doanthanhnam1/Gear-reduce/calculate parameter.pdf

Tên: Đoàn Thanh Nam

MSSV: 20146506
Đề số 3 – phương án 8

Bài làm
Câu 1: tính toán công suất và tốc độ quay của trục công tác
1. Tốc độ quay của trục công tác ta có thể áp dụng công thức:

n =

Q
60FtμρLmTan(β)

Trong đó: Ft =

πD

2

4

=

3.14∗0.6

2

4

= 0.283(m²
)

L = mKDTan(β) =

1
3

∗ 200 ∗ 0.6 ∗ Tan(3

o
) = 0.296(m)
Vậy tốc độ quay n của trục công tác là:

n =

Q
60FtμρLmTan(β)

=

14800

60 ∗ 0.283 ∗

1
3

∗ 1300 ∗ 2.096 ∗

1
3

∗ Tan(3

o)
= 55.01(vg/pℎ)
2. Công suất cần cung cấp cho thùng trộn là: (đổi 81o =1.414 rad)
- Công suất nâng vật liệu lên độ cao thích hợp P1 là:

w =

πn
30 =

3.14 ∗ 55.01
30 = 5.76(rad/s)

P1 =

GV ∗ R0 ∗ (1 − Cos(α)) ∗ w α

∗ 10⁻³

=

2400 ∗

0.6
3

∗ (1 − Cos(1.414)) ∗ 5.76
1.414

∗ 10⁻³

= 1.65(kw)

- Công suất trộn vật liệu P2 là:

P2 =

GV ∗ R0 ∗ w ∗ Sin(α)
1000 | =

2400 ∗

0.6
3

∗ 5.76 ∗ Sin(1.414)
1000
= 2.73(kw)
- Công suất mất mát do ma sát ở ổ trục và thùng trộn là: P3 = 0.1(P1 + P2

) = 0.1(1.65 + 2.73) =0.44(kw)

Vậy công suất cần cung cấp cho trục công tác là:

P = P1 + P2 + P3 = 1.65 + 2.73 + 0.44 = 4.82(kw)

Vận tốc quay n của trục công tác là:

n = 55.01(vg/ph)

Câu 2: Chọn động cơ và phân phối tỉ số truyền:

1. Chọn động cơ
Công suất trên trục công tác là: P = 4.82(kw) Hiệu suất của hệ thống là:

η = η01η12η23 = ηknηbrηxηol

3
Bánh trụ răng côn được che kín nên chọn ηbr = 0.96
Bộ truyền xích để hở nên chọn ηx = 0.93
Cặp ổ lăn chọn ηol = 0.995
Vậy hiệu suất hệ thống η = 1 ∗ 0.96 ∗ 0.93 ∗ 0.995³ = 0.88 ➔ Công suất cần thiết trên trục động cơ là: Pdc =

P
η

=

4.82
0.88

= 5.48(kw)
Ta có tốc độ quay trên trục công tác là n = 55.01(vg/ph)
- Chọn sơ bộ tỉ số truyền:
Tỉ số truyền nên dùng của hộp giảm tốc một cấp là 2..4 Tỉ số truyền nên dùng cho truyền động xích là 2..5
Vậy tỉ số truyền của cả hệ là 2*2..4*5 là 4..20
Vậy chọn usb = 13
Số vòng quay sơ bộ: nsb = usb*n = 13*55.01 = 715.13(vg/ph)

Số vòng quay đồng bộ: ndb = 750(vg/ph)

Chọn động cơ thỏa điều kiện:

u = 380V
Pct < Pdc
ndb = 750

➔ Kết quả:
Động cơ | 160M8B
Công suất (kw) | 5.5
Số vòng quay (vg/ph) | 715
Khối lượng (kg) | 125
Moment quán tính (kgm² ) | 0.09524
2. Phân phối tỉ số truyền:
- Tính tỉ số truyền thực ut =

ndc

nct

=

715
55.01

= 13
- Chọn tỉ số truyền của hộp giảm tốc: ubr = 4.0
- Tỉ số truyền ngoài hộp giảm tốc: ux =

ut

ubr

=

13
4

= 3.3

- Kiểm tra sai lệch: ∆u =

|ut−u|
ut

=

|13−4∗3.3|
13

=

|13−13.2|
13

= 1.54% ≤ 4%
- Tính số vòng quay trên các trục: Trục 01: n1 = ndc = 715(vg/ph) Trục 02: n2 =

n1

ubr

=

715
4

= 178.75(vg/pℎ)

Trục công tác: nct =

n2
ux

=

178.75
3.3

= 54.17 (vg/pℎ)

- Tính công suất trên các trục: Trục 02: P2 =

Pct
η23

=

Pct

ηxηol

=

4.82
0.93∗0.995

= 5.21(kw)

Trục 01: P1 =

P2
η12

=

P2

ηbrηol

=

5.21
0.96∗0.995

= 5.45(kw)

Trục động cơ: Pdc =

P1
η01

=

P1

ηntηol

=

5.45
1∗0.995

= 5.48(kw)

- Tính moment trên các trục:

Tdc =

9.55 ∗ 10⁶
∗ 5.48
715 | = 73194(Nmm)

Trục 01:

T1 =

9.55 ∗ 10⁶
∗ 5.45
715 | = 72794(Nmm)

Trục 02:

T2 =

9.55 ∗ 10⁶
∗ 5.21
178.75 = 278352(Nmm)

Trục công tác:

Tct =

9.55 ∗ 10⁶
∗ 4.82
54.17 = 849751(Nmm)

Bảng đặc tính kỹ thuật:

Trục Thông số | Động cơ | I | II | Công tác
Công suất (kw) | 5.48 | 5.45 | 5.21 | 4.82
Tỉ số truyền | unt = 1 ubr = 4 ux = 3.3
Tốc độ quay (v/ph) | 715 | 715 | 178.75 | 54.17
Momen xoắn (Nmm) | 73194 | 72794 | 278352 | 849751

Câu 3: tính toán bộ truyền ngoài hộp giảm tốc: bộ truyền xích

- Dựa vào bảng ở câu 2, ta có:
Công suất trên trục của đĩa xích dẫn P1 = P2 = 5.21(kw)
Tốc độ quay trên trục chứa đĩa xích dẫn n1 = n2 = 178.75(vg/ph) Tỷ số truyền của bộ truyền xích ux = 3.3
- Chọn lọai xích → Chọn ống xích con lăn vì vận tốc thấp
- Chọn số răng đĩa xích Z1 và Z2:
Z1 = 29 − 2 ∗ 3.3 = 22.4 ≥ 19 → Chọn Z1 = 23
Z2 = u ∗ Z1 = 3.3 ∗ 23 = 75.9 ≤ Zmax = 120 → Chọn Z2 = 77 Tính tỉ số truyền thực tế: ut =

Z2
Z1

=

77
23

= 3.35

Kiểm tra sai lệch tỉ số truyền: ∆u =

|ut−u|
ut

=

|3.35−3.3|
3.35

= 1.49% ≤ 4%

- Xác định bước xích p
kn =

n01
n1

=

200
178.75

= 1.12

kZ =

Z01
Z1

=

25
23

= 1.09
k = kđ ∗ ka ∗ k0 ∗ kdc ∗ kbt ∗ kc = 1 ∗ 1 ∗ 1 ∗ 1 ∗ 1.3 ∗ 1.25 = 1.62

Xích 1 dãy (kd = 1) có công suất tính toán: Pt =

P1∗k∗kZ∗kn
kd

=

5.21∗1.62∗1.09∗1.12
1

=10.3(kw)
Tra bảng công suất cho phép của xích con lăn khi n01 = 200 Pt ≤ [Po

] = 11(kw)
➔ Chọn bước xích: p = 25.4 ≤ pmax

∆P =

11 − 10.3
10.3

∗ 100% = 6.8%

Tuy ∆P < 10% nhưng với p = 25.4mm thì đường kính đĩa xích bị dẫn lớn

d2 =

25.4

sin (

180
77 )

= 622(mm)

Trong điều kiện này ta nên chọn p có trị số nhỏ hơn và tăng số đĩa xích, bằng cách thay đổi số dãy xích theo công thức:

Pt =

P1 ∗ k ∗ kZ ∗ kn
kd

< [P] → kd >

10.3
4.8

= 2.15

Vì kd > 2.15 → kd = 2.5 tương đương là 3 dãy xích có bước xích p = 19.05 mm

- Xác định khoảng cách trục a và số mắt xích X
Chọn asb = 40p = 40*19.05= 762 mm
Tính số mắt xích X:

X =

2a
p

+

(Z1 + Z2

)
2

+

p
a

(

Z2 − Z1
2π

)

2

=

2 ∗ 762
19.05 +

(23 + 77)
2

+

19.05
762 (

77 − 23
2 ∗ 3.14)

2
= 131.85
Lấy số mắt xích chẵn: X=132 (mắt xích) Tính lại khoảng cách trục a:

a

′ =

1
4

p [X −
(Z1 + Z2

)
2

+ √(X −
Z1 + Z2
2

)

2
− 2 (

Z2 − Z1
π

)

2

]

=

1
4

19.05 [132 −
(23 + 77)
2

+ √(132 −
(23 + 77)
2

)

2 − 2(

(77 − 23)
3.14 )

2]

= 763.5(mm)
Để xích không quá căng thì giảm a một lượng:

a = a

′ − ∆a =763.5-0.003*763.5=761.21≈ 762 số lần va đập trong 1 giây: i =

Z1n1
15X

=

23∗178.75
15∗132

= 2.08 ≈ 2 ≤ [i] = 35

- Kiểm nghiệm xích về độ bền S =

Q
kđFt+F0+Fv

≥ [S]

kf = 4 do xích nghiêng góc 30o Q = 108*10³
(tra bảng xích 3 dãy)
1m xích nặng q = 5.8kg
F0 = 9.81kf*q*a = 9.81*4*5.8*0.761 =172.2(N)

v =

Z1n1p
60000 =

23 ∗ 178.75 ∗ 19.05
60000 | = 1.31(m/s)
Fv = qv

2 = 5.8 ∗ 1.31² = 9.95(N)

Ft =

1000P2
v

=

1000 ∗ 5.21
1.31 = 3977.1(N)

Vậy S =

Q
kđFt+F0+Fv

=

108000
1∗3977.1+172.2+9.95
| = 25.97

Theo Bảng 5.10 với p = 19,05; n2 = 178.75 v/ph Þ [S] = 8,2 Vậy S = 25.97 > [S] = 8,2: bộ truyền xích đảm bảo độ bền
- Các thông số của đĩa xích

Đường kính vòng chia đĩa xích:

d1 = p/sin(180/z1) = 19.05/sin(180/23)=140mm
d2 = p/sin(180/z2) = 19.05/sin(180/77)=467.04mm lấy d2 = 467mm

Đường kính vòng đỉnh răng:

da1 = p[0,5 + cotg(π/z1 )] = 19.05[0.5+cotg(π/23)] = 148mm

da2 = p[0,5 + cotg(π/z2 )] = 19.05[0.5+cotg(π/77)] = 476mm

Đường kính vòng chân răng:

df1 = d1 - 2r = 140 – 2*(0.5025*11.91+0.05) = 128mm

df2 = d2 - 2r = 467 – 2*(0.5025*11.91+0.05) = 455mm

- Kiểm nghiệm độ bền tiếp xúc của đĩa xích:
σH = 0,47√kr(Ftkđ + Fvđ)
| E
| Akd

Trong đó:

kr = 0.48 + (23 − 20) ∗

0.36 − 0.48
30 − 20 = 0.444

A = 265mm²

kđ = 1

kd = 2.5

Fvđ = 13*10⁻⁷*n1*p³m= 13*10⁻⁷*178.75*19.05³*1=1.61 (N)

Vậy:
σH = 0.47√0.444(3977.1 + 1.61) 2.1 ∗ 10⁵
265 ∗ 2.5

= 351.7(MPa)

Vì vật liệu là sắt 45 có [σH] = 500 (MPa) > σH = 351.7 nên thõa điều kiện

- Lực tác dụng lên trục:
Fr = kx ∗ Ft = 1.15 ∗ 3977.1 = 4573.67

Các thông số bộ truyền xích:

Thông số | Kí hiệu | Trị số
Khoảng cách trục | a (mm) | 762
Số răng đĩa xích dẫn | Z1 | 23
Số răng đĩa xích bị dẫn | Z2 | 77
Tỉ số truyền | u | 3.35
Số mắt xích | X | 132
Đường kính vòng chia đĩa xích dẫn | d1 | 140
Đường kính vòng chia đĩa xích bị dẫn | d2 | 467
Đường kính vòng đỉnh đĩa xích dẫn | da1 | 148
Đường kính vòng đỉnh đĩa xích bị dẫn | da2 | 476
Đường kính vòng chân răng đĩa xích dẫn | df1 | 128
Đường kính vòng chân răng đĩa xích bị dẫn | df2 | 455
Bước xích | P (mm) | 19.05
Số dãy xích | | 3

Câu 3 (part 2): tính toán bộ truyền trong hộp giảm tốc: bánh răng côn

Dựa vào bảng đặc tính kĩ thuật ở câu 2, ta có:
Công suất trên trục bánh răng dẫn: P1 = 5.45 (kW)

Tốc độ quay trên trục bánh răng dẫn n1 = 715 (vg/ph)

Tỉ số truyền u = ubr = 4

Mô men xoắn trên trục bánh răng dẫn T1 = 72794 (Nmm)

Thời gian làm việc 5 năm (300 ngày/năm, 2 ca/ngày, 6 giờ/ca) (đề cho)

- Chọn vật liệu:
Bánh răng dẫn: thép 45 tôi cải thiện, đạt độ rắn HB 241 ÷ 285 có giới hạn bền σb1 = 850 MPa, giới hạn bền chảy σch1 = 580 MPa, chọn độ rắn bánh răng dẫn HB1 = 250 MPa

Bánh răng bị dẫn: thép 45 tôi cải thiện, đạt độ rắn HB 192 ÷ 240 có giới hạn bền σb2 = 750 MPa, giới hạn bền chảy σch2 = 450 MPa, chọn độ rắn bánh răng bị dẫn HB2 = 235 MPa.

- ứng suất cho phép:

với thép 45, tôi cải thiện đạt độ rắn HB 180 ÷ 350:

σHlim

o | = 2HB + 70; SH = 1.1; σFlim
o | = 1.8HB; SF = 1.75

σHlim1

o | = 2HB1 + 70 = 570 MPa; σFlim1
o | = 1.8HB1 = 450 MPa

σHlim2

o | = 2HB2 + 70 = 540 MPa; σFlim2
o | = 1.8HB2 = 423 MPa

NHo = 30HHB

2.4

→ NHo1 = 30 ∗ 250².4 = 1.7 ∗ 10⁷

; NHo2 = 30 ∗ 235².4 = 1.47 ∗ 10⁷

Khi bộ truyền làm việc với tải trọng tĩnh:

NHE = NFE = 60cnt∑

t∑ = 5 ∗ 300 ∗ 2 ∗ 6 = 18000 giờ
NHE1 = NFE1 = 60cnt∑ = 60 ∗ 1 ∗ 715 ∗ 18000 = 77.22 ∗ 10⁷

NHE2 = NFE2 = 60c

n1
u1

t∑ = 60 ∗ 1 ∗

715
4

∗ 18000 = 19.31 ∗ 10⁷

NHE2 > NHo2 do đó KHL2 = 1

Tương tự NHE1 > NHo1 do đó KHL1 = 1

Như vậy, sơ bộ xác định được

[σH] = σHlim1

o KHL/SH

[σH1

] = 570 ∗

1
1.1

= 518.18 MPa

[σH1

] = 540 ∗

1
1.1

= 490.9 MPa

Bộ truyền bánh răng nón răng thẳng nên chọn [σH] có trị số nhỏ hơn của [σH1] và [σH2]: [σH] = [σH2] 490,9 MPa
Vì NFE2 > NFo do đó KFL2 = 1

Tương tự NFE1 > NFo1 do đó KFL1 = 1

Bộ truyền quay 1 chiều KFC = 1

[σF

] = σFlim

o KFCKFL/SF

[σF1

] = 450 ∗ 1 ∗

1
1.75 = 257.14 MPa

[σF2

] = 423 ∗ 1 ∗

1
1.75 = 241.71 MPa

ứng suất quá tải cho phép được xác định:

với tôi cải tℎiện: [σH]max = 2.8σcℎ2 = 2.8 ∗ 450 = 1260 MPa

với HB < 350: [σF1

]max = 0.8σcℎ1 = 0.8 ∗ 580 = 464 MPa

[σF2

]max = 0.8σcℎ2 = 0.8 ∗ 450 = 360 MPa

- Chiều dài côn ngoài được tính theo công thức:

Re = KR√u

2 + 1√
T1KHβ
(1 − Kbe)Kbeu[σH]

2

3

Trong đó KR = 0,5Kd = với Kd = 100 MPa¹/3 = khi bộ truyền bánh răng côn bằng thép. Chọn Kbe = 0,25

(Kbe chỉ thay đổi trong phạm vi hẹp Kbe = 0,25÷0,3 với u > 3 → chọn 0.25)

Kbeu
2 − Kbe

=

0.25 ∗ 4
2 − 0.25 = 0.57

Tra bảng kết hợp HB < 350, ta chọn KHβ = 1.13 (trục bánh răng côn lắp trên ổ đũa, sơ đồ I, HB < 350)

mômen xoắn trên trục bánh răng dẫn T1 = 72794

Tính được:

Re = 50√4

2 + 1√
72794 ∗ 1.13
(1 − 0.25) ∗ 0.25 ∗ 4 ∗ 490.9

2

3
= 158.58 mm
- Xác định các thông số ăn khớp: Số răng bánh dẫn:

de1 =

2Re
√1 + u
2

=

2 ∗ 158.58
√1 + 4
2

= 76.92 mm

Với de1 = 76.92mm và u = 4, tra bảng ta được Z1p = 17

Với HB < 350, Z1 = 1.6 *Z1p = 1.6*17=27.2≈ 28

Đường kính trung bình với module trung bình:
dm1 = (1 − 0.5Kbe)de1 = (1 − 0.5 ∗ 0.25) ∗ 76.92 = 67.3 mm

mtm =

dm1
Z1

=

67.3
28 = 2.4 mm

mte =

mtm
1 − 0.5Kbe

=

2.4
1 − 0.5 ∗ 0.25 = 2.74 mm

Chọn mte = 3

Tính lại:
mtm = mte(1 − 0.5Kbe) = 3 ∗ (1 − 0.5 ∗ 0.25) = 2.63 mm

dm1 = mtm ∗ Z1 = 2.63 ∗ 28 = 73.64 mm

Số răng bánh bị dẫn:

Z2 = uZ1 = 4 ∗ 28 = 112, chọn Z2 = 112

Do đó tỉ số truyền um =

112
28

= 4

Sai số tỉ số truyền ∆u =

u−um
u

∗ 100 =

4−4
4

∗ 100 = 0% < 2%

Góc côn chia:
δ1 = arctg (

Z1
Z2

) = arctg (

28
112) = 14°2
′11′′

δ2 = 90° − δ1 = 90° − 14°16′52′′ = 75°57′49′′

Chiều dài côn ngoài đời thực:

Re = 0.5 ∗ mte√Z2
2 + Z1

2 = 0.5 ∗ 3√112² + 28² = 173.17 mm

- Kiểm nghiệm răng về độ bền tiếp xúc
Ứng suất tiếp xúc trên bề mặt răng được tính theo công thức: σH = ZmZHZε√
2T1KH√u
2 + 1
0.85bdm1

2 u
Zm = 274MPa¹/3
Bộ truyền bánh răng côn răng thẳng nên ZH = 1,76 Hệ số trùng khớp ngang εα được tính theo:

εα = [1.88 − 3.2 (

1
Z1

+

1
Z2

)] cos(βm) = 1.88 − 3.2 (

1
28 +

1
112) ∗ 1 = 1.74

Zε = √(4 − εα)/3 = √(4 − 1.74)/3 = 0.87

KH = KHβKHαKHv

Với bánh răng côn răng thẳng thì KHα = 1

Vận tốc: v =

πdm1n1
60000

=

π∗73.64∗715
60000

= 2.76 (m/s)

Chọn cấp chính xác theo vận tốc vòng, cấp chính xác: cấp 8

Công thức: vH = δHg0v√dm1(u + 1)/u

δH là hệ số kể đến ảnh hưởng của các sai số ăn khớp, δH = 0.006

g0 là hệ số kể đến ảnh hưởng của sai lệch các bước răng bánh 1 và 2

g0 = 56 (cấp cℎínℎ xác 8)

Thay các trị số trên, ta được:

vH = 0.006 ∗ 56 ∗ 2.76√73.64 ∗
4+1
4

= 8.9

Chiều rộng vành răng b = KbeRe = 0.25 ∗ 173.17 = 43.29, lấy b = 44mm

Thay các trị số trên để tính KHv

KHv = 1 +

vHbdm1

2T1KHβKHα

= 1 +

8.9∗44∗73.64
2∗72794∗1.13∗1

= 1.18

Dó đó: KH = KHβKHαKHv = 1.13 ∗ 1 ∗ 1.18 = 1.33

Ứng suất tiếp xúc:

σH = ZmZHZε√
2T1KH√u²+1
0.85bdm1

2 u

= 274 ∗ 1.76 ∗ 0.87√
2∗72794∗1.33∗√4
2+1
0.85∗44∗73.64²∗4
= 416.2 MPa

➔ σH < [σH] = 490.9 MPa Thõa mãn độ bền tiếp xúc
- Kiểm nghiệm răng về độ bền uốn:

Để đảm bảo độ bền uốn cho răng, ứng suất uốn sinh ra tại chân răng được tính theo công thức:

σF1 = 2T1 ∗ KF ∗ Yε ∗ Yβ ∗ YF1

/(0.85bdm1mnm) < [σF1

]

Với trị số

Kbeu
2−Kbe

=

0.25∗4
2−0.25

= 0.57, chọn KFβ = 1.25

KFα = 1 do bánℎ răng côn răng tℎẳng

hệ số kể đến tải trọng động xuất hiện trong vùng ăn khớp, tính theo công thức: KFv = 1 + vFbdm1/(2T1KFβKFα)

với vF = δFg0v√dm1(u + 1)/u

δF = 0.016

g0 = 56 (cấp chính xác 8)

vF = 0.016 ∗ 56 ∗ 2.76√
73.64 ∗ (4 + 1)
4

= 23.73

KFv = 1 +

23.73 ∗ 44 ∗ 73.64
2 ∗ 72794 ∗ 1.25 ∗ 1

= 1.42

Do đó: KF = KFβ ∗ KFα ∗ KFv = 1.25 ∗ 1 ∗ 1.42 = 1.78

với răng thẳng Yβ = 1

Yε =

1
εα

=

1
1.74 = 0.57

Số răng của bánh răng tương đương:

Zvn1 =

Z1
cos(δ1

)

=

28
cos (14°2

′11′′)

= 28.86

Zvn2 =

Z2
cos(δ2

)

=

112
cos (75°57′49′′)

= 462.96

Chọn bánh răng không dịch chỉnh, tra bảng, ta được

YF1 = 3.8; YF2 = 3.6

σF1 =

2 ∗ 72794 ∗ 1.78 ∗ 0.57 ∗ 1 ∗ 3.8
0.85 ∗ 44 ∗ 73.64 ∗ 2.63 = 77.49MPa < [σF1

] = 257.14MPa

σF2 = σF1

∗

YF2

YF1

= 77.49 ∗

3.6
3.8

= 73.41 MPa < [σF2

] = 241.71 MPa

Thỏa độ bền uốn

- Kiểm nghiệm răng về quá tải: Hệ số quá tải Kqt =

Tmax
T

= 1
Để tránh biến dạng dư hoặc gãy giòn bề mặt, ứng suất tiếp xúc cực đại phải thỏa điều kiện:

σHmax = σH√Kqt = 427.91√1 = 427.91 MPa < [σH]max = 1260 MPa

Kiểm nghiệm quá tải về độ bền uốn theo công thức:

σF1max = σF1√Kqt = 77.49√1 = 77.49MPa < [σF1
]max = 464 MPa σF2max = σF2√Kqt = 73.41√1 = 73.41 MPa < [σF2
]max = 360 MPa
- Bảng thiết kế bộ truyền bánh răng côn răng thẳng
Thông số | Ký hiệu | Giá trị | Đơn vị
Chiều dài côn ngoài | Re | 173.17 | mm
Mô đun vòng ngoài | mte | 3 | mm
Tỉ số truyền | ut | 4
Chiều rộng vành răng | b | 44 | mm
Góc côn chia | δ1; δ2 | ′11′′ δ1 = 14°2 δ2 = 75°57′49′′ | Độ
Số răng bánh nhỏ | Z1 | 28 | Răng
Số răng bánh lớn | Z2 | 112 | Răng
Hệ số dịch chỉnh | x1; x2 | x1 = 0; x2 = 0
Góc nghiên của răng | β | 0 | Độ
Công suất trục bánh răng dẫn | P1 | 5.45 | Kw
Tốc độ quay của trục dẫn | n1 | 715 | Vg/ph
Mô men xoắn trên trục dẫn | T1 | 72794 | Nmm
Thời gian làm việc | t∑ | 18000 | Giờ
Đường kính vòng chia ngoài bánh nhỏ | de1 | mte* Z1=84 | mm
Đường kính vòng chia ngoài bánh lớn | de2 | mte* Z2=336 | mm
Đường kính đỉnh răng ngoài bánh nhỏ | da1 | mte(Z1+2*cos(δ1)) = 90 | mm
Đường kính đỉnh răng ngoài bánh lớn | da2 | mte(Z2+2*cos(δ2))=338 | mm

PHẦN IV. TÍNH TOÁN VÀ THIẾT KẾ TRỤC

Trục Động cơ | Động cơ | I | II | Làm việc
Công suất (kw) | 5.48 | 5.45 | 5.21 | 4.82
Tỉ số truyền | unt = 1 ubr = 4 ux = 3.3
Tốc độ quay (v/ph) | 715 | 715 | 178.75 | 54.17
Momen xoắn (Nmm) | 73194 | 72794 | 278352 | 849751
- Bảng thiết kế bộ truyền bánh răng côn răng thẳng:
Thông số | Ký hiệu | Giá trị | Đơn vị
Chiều dài côn ngoài | Re | 173.17 | mm
Mô đun vòng ngoài | mte | 3 | mm
Tỉ số truyền | ut | 4
Chiều rộng vành răng | b | 44 | mm
Góc côn chia | δ1; δ2 | δ1 = 14°2 ′11′′ δ2 = 75°57′49′′ | Độ
Số răng bánh nhỏ | Z1 | 28 | Răng
Số răng bánh lớn | Z2 | 112 | Răng
Hệ số dịch chỉnh | x1; x2 | x1 = 0; x2 = 0
Góc nghiên của răng | β | 0 | Độ
Công suất trục bánh răng dẫn | P1 | 5.45 | Kw
Tốc độ quay của trục dẫn | n1 | 715 | Vg/ph
Mô men xoắn trên trục dẫn | T1 | 72794 | Nmm
Thời gian làm việc | t∑ | 18000 | Giờ
Đường kính vòng chia ngoài bánh nhỏ | de1 | mte* Z1=84 | mm
Đường kính vòng chia ngoài bánh lớn | de2 | mte* Z2=336 | mm
Đường kính đỉnh răng ngoài bánh nhỏ | da1 | mte(Z1+2*cos(δ1)) = 90 | mm
Đường kính đỉnh răng ngoài bánh lớn | da2 | mte(Z2+2*cos(δ2))=338 | mm
Lực vòng | Ft | 2T1 = 1977.02 Ft1 = Ft2 = dm1 | N

Lực hướng tâm | Fr | Fr1 = Fa2 = Ft1 ∗ tan20 ∗ cosδ1 = 698.09 | N
Lực dọc trục | Fa | Fa1 = Fr2 = Ft1 ∗ tan20sinδ1 = 174.52 | N

### 1. Chọn vật liệu

Vật liệu dùng để chế tạo trục cần có độ bền cao, ít nhạy cảm với sự tập trung ứng suất dễ gia công và có thể nhiệt luyện dễ dàng. Cho nên thép cacbon và thép hợp kim là những vật liệu chủ yếu để chế tạo trục.

Vật liệu | σb | σch | HB
Thép 45 tôi cải thiện | 750 Mpa | 450 Mpa | 192 … 240

### 2. Tính toán thiết kế trục

a. Tải trọng tác dụng lên trục
Tải trọng chủ yếu tác dụng lên trục bao gồm momen xoắn và các lực ăn khớp trong bộ truyền bánh răng, lực căng xích,… Bỏ qua trọng lượng trục , các chi tiết trên trục và lực ma sát được sinh ra ở ổ lăn.
b. Lực tác dụng từ bộ truyền bánh răng côn

Các lực tác dụng vào bộ truyền bánh răng côn khi chúng ăn khớp bao gồm:

+Ft: Lực vòng

+Fr: Lực hướng tâm;

+Fa: Lực dọc trục;

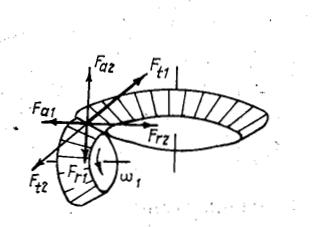
[picture p1: figure]

Trị số các lực được tính toán theo công thức sau:

Ft1 = Ft2 =

2T1

dm1

=

2.72794
73.64 = 1977.02(N)

Fr1 = Fa2 = Ft1 tan 20⁰
cos δ1
= 1977.02.tan 20⁰
. cos(14°2′11′′) = 698.09 (N) Fa1 = Fr2 = Ft1 tan 20⁰

sin δ1 = 1977.02.tan 20⁰
. sin(14°2′11′) = 174.52(N)
c. Lực tác dụng từ bộ truyền xích

+Lực tác dụng lên trục:
Fr = kx ∗ Ft = 1.15 ∗ 3977.1 = 4573.67 (N)

Trong trường hợp góc đường nối tâm giữa bánh răng với trục y là một góc khác không thì phân thành các thành phần lực vuông góc với nhau:

Fx = Frcos(φ) = 4573.67. cos(30) = 3960.91(N)

Fy = Frsin(φ) = 4573.67. sin(30) = 2286.84(N)

Đối với khớp nối được tính theo công thức: Fr = (0,2 … 0,3)Ft

Với Ft là lực vòng trên khớp nối có thể được tính toán theo công thức: Ft =

2T
Dt
Với Dt=d1 (đường kính vòng chia xích dẫn) =140 (mm)

=> Ft =

2.278352
140

= 3976.46 (N)

Như vậy ta được: Fr = (0,2 … 0,3). 3976.46 = (795.29 … 1192.94)(N)

Chọn: Fr = 1000 (N)

### 3. Tính toán thiết kế trục

a. Xác định đường kính sơ bộ của trục
Đường kính trục thứ k trong hộp giảm tốc chỉ xác định bằng momen được tính theo công thức:

dk

sb ≥ √
Ti
0,2[τ]

3

Trong đó:
- Ti - mô men xoắn của trục thứ i;

TI = 72794 Nmm; TII =278352 Nmm

-[τ] : ứng suất xoắn cho phép, với vật liệu trục là thép 45

[τ]= (15..30) Mpa
ta chọn [τ] suất xoắn cho phép với vật liệu là thép, Mpa với vật liệu thép

45 [τ]= (15...30) Mpa, ta chọn [τ]1 = 15 Mpa ; [τ]2 = 30 Mpa.

Ta tính ra được :

d1

sb ≥ √
T1
0,2[τ]

3

≥ √
72794
0,2.15

3
≥ 28.95 (mm)

d2

sb ≥ √
T2
0,2[τ]

3

≥ √
278352
0,2.30

3
≥ 35.93 (mm)

Dựa vào bảng 10.2, ta lấy : d1

sb = 30 (mm), d2

sb = 40 (mm),

Như vậy ta có được kết quả như sau:

- Đường kính sơ bộ trục I: d1

sb = 30 (mm)
- Đường kính sơ bộ trục II: d2

sb = 40 (mm)

Dựa vào đường kính sơ bộ trục, ta có thể suy ra được chiều rộng của ổ lăn b0 từ bảng 10.2:

d1

sb = 30 (mm) => b01 = 19 (mm)

d2

sb = 40 (mm) => b02 = 23 (mm)

b. Xác định chiều dài của Mayơ đĩa

Chiều dài của Mayơ đĩa xích được tính toán theo công thức :

lmx = lm22 = (1,2. . .1,5)d2

sb = (1,2. . .1,5).40 = (48. . .60) (mm)

Chọn lm22=54 (mm)
Chiều dài của Mayơ bánh răng côn được xác đinh bằng công thức :

lmbrc = (1,2. . .1,4)d

- Với bánh răng côn nhỏ :
lm13 = (1,2. . .1,4)d1

sb = (1,2. . .1,4).30 = (36. . .42)(mm).

Chọn lm13=39 (mm)

- Với bánh răng côn lớn :
lm23 = (1,2. . .1,4)d2

sb == (1,2. . .1,4).40 =
(48. . .56)(mm).

Chọn lm23=52 (mm)
Chiều dài của Mayơ nửa khớp gối (đối với vòng đàn hồi):

lm = (1,4 … 2,5)d

=> lm12 = (1,4. . .2,5)d1

sb = (42. . .75)(mm)

Chọn lm12=59 (mm)

c. Các khoảng cách khác được chọn trong bảng 10.3:
- Khoảng cách từ mặt mút của chi tiết quay đến thành trong của hộp hoặc. khoảng cách giữa các chi tiết quay.

k1 = (8…15) mm lấy k1= 10 mm

- Khoảng cách từ mặt cạnh ổ đến thành trong của hộp.

k2= (5…15) (mm) lấy k2= 10 mm

- Khoảng cách từ mặt mút của chi tiết quay đến nắp ổ.

k3 = (10…20) (mm) lấy k3= 10 mm

- Chiều cao lắp ổ và đầu bulông.

hn = (15...20) (mm) lấy hn=20 mm

d. Xác định chiều dài các đoạn trục

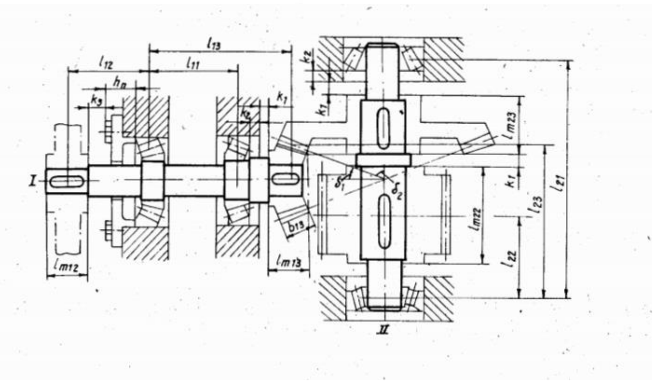
[picture p2: figure]

Ta có như sau :
k : số thứ tự của trục trong hộp giảm tốc, k = 1, ...t, với t là số trục của hộp giảm tốc (t = 2 đối với hộp giảm tốc 1 cấp, t = 3 đối với hộp giảm tốc 2 cấp v.v...).
i : số thứ tự của tiết diện trục trên đó láp các chi tiết có tham gia truyển tải trọng :
i = 0 và 1 : các tiết diện trục lắp ổ ;
i = 2...S, với s là số chi tiết quay (bánh đai, bánh ràng, bánh vít, trục vít, đĩa xích và khớp nối) ;
lkl : khoảng cách giữa các gối đỡ 0 và 1 trên trục thứ k ;
lkj : khoảng cách từ gối đỡ 0 đến tiết diện thứ i trên trục thứ k ;
lmki : chiều dài mayơ của chi tiết quay thứ i (lắp trên tiết diện i) trên trục k, tính theo công thức (10.10)... (10.13) tùy theo loại chi tiết quay, trong đó thay d bằng dk tính theo Tk ;

lcki - khoảng côngxôn (khoảng chìa) trên trục thứ k, tính từ chi tiết thứ i ở ngoài hộp giảm tốc đến gối đỡ
lcki = 0,5. (lmki + b0) + k3 + ℎn | (10.14)
bki - chiêu rộng vành bánh rảng thứ i trên trục thứ k.
- Đối với trục I:
l12 = −lc12 = − (

lm12
2

+ k3 + ℎn +

b01
2

) = − (

59
2
| + 10 + 20 +
| 19
| 2

)

= −69 (mm)
l11 = (2,5. .3)d1 = (2,5. . .3)30 = (75. . .90) (mm)
Ta chọn l11=83 (mm)

l13 = l11 + k1 + k2 + lm13 + 0,5(b01 − b13cos(δ1)) = 83 + 10 + 10 +39+0,5(19-44.cos (14’2’11’’)) =130.16 (mm)

- Đối với trục II:
l22 = 0,5(lm22 + b02) + k1 + k2 = 0,5(54 + 23) + 10 + 10 = 58.5 (mm)
l23 = l22 + 0,5(lm22 + b13cos(δ2)) + k1)
= 58.5 + 0,5(54 + 44. cos(75°57′49′′)) + 10 = 100.84 (mm)
l21 = lm22 + lm23 + b02 + 3k1 + 2k2 = 54 + 52 + 23 + 3.10 + 2.10 = 179 (mm)

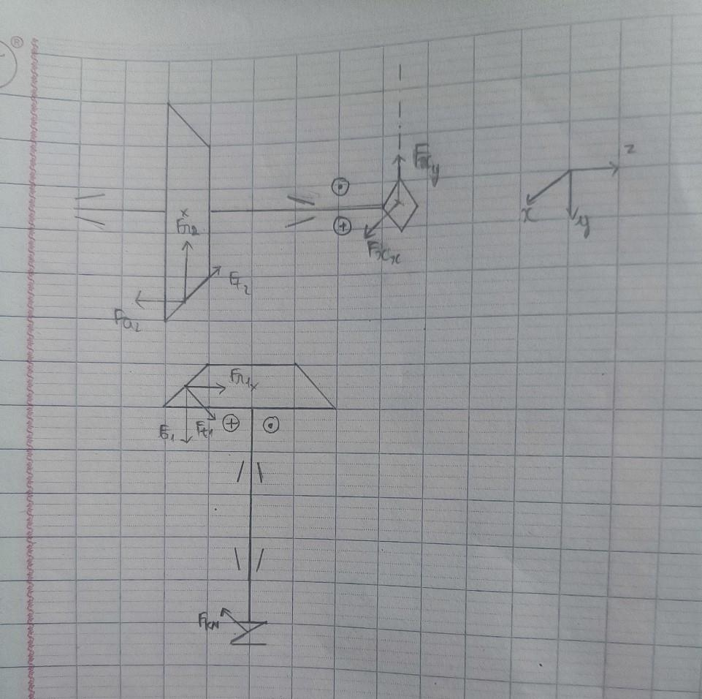
[picture p3: figure]

### 4. Tính toán thiết kế trục I

a. Sơ đồ đặt lực trên trục I

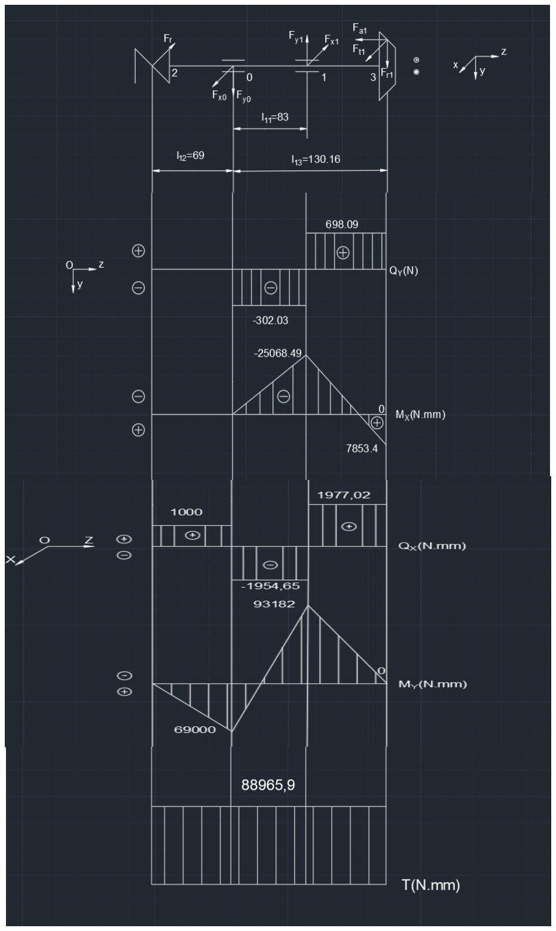
[picture p4: page 23]

b. Xác định các lực tác dụng lên trục I

* Các lực tác dụng lên trục I gồm có:
+ Mô men xoắn từ trục động cơ truyền cho trục I, TI = 72794 (Nmm); + Lực vòng: Ft1= 1977.02 (N)

+ Lực hướng tâm: Fr1= Fa2 =698,09 (N)

+ Lực dọc trục : Fa1 = Fr2= 174,52(N) + Lực của khớp nối: Fr = 1000 (N)

- Xác định các phản lực tại gối đỡ
Xét tổng moment trên gối đỡ (0) trên mặt phẳng yOz:

∑Mx(0) = Fy1l11 + Fa1

da1
2

− Fr1l13 = 0

=> Fy1 =

Fr1l13 − Fa1

dm1
2
l11

=

698,09 ∗ 130,16 − 174,52 ∗

90
2
83 | = 1000,12 (N)

Xét tổng các lực theo phương y:

∑Fy = Fy0 − Fy1 + Fr1 = 0

=> Fy0 = Fy1 − Fr1 = 1000,12 − 698,09 = 302,03 (N)

Xét tổng moment trên gối đỡ (0) trên mặt phẳng xOz:

∑ My(0) = Fr
l12 − Fx1l11 + Ft1

l13 = 0

=> Fx1 =

Fr

l12 + Ft1

l13
l11

=

1000 ∗ 69 + 1977,02 ∗ 130,16 83
= 3931,67 (N)

Xét tổng các lực theo phương x:

∑Fx = Fx0 − Fx1 − Fr + Ft1 = 0

=> Fx0 = −Ft1 + Fr + Fx1 = −1977,02 + 1000 + 3931,67 = 2954,65 (N)

Vì lực Fa1 quay quanh trục Ox nên tạo ra một moment:

Ma1 = Fa1

da1
2

= 174,52 ∗

90
2

= 7853,4 (Nmm)

T1 = Ft1 ∗

da1
2

= 1977.02 ∗

90
2

= 88965,9 (N)

- Tính toán đường kính của các trục tiết diện:

Theo phần chọn sơ bộ đường kính trục, ta có dI

sb= 30 (mm), vật liệu chế

tạo trục I là thép 45, tôi cải thiện, có σb ≥ 750 MPa; theo bảng 10.5, ta có trị số của ứng suất cho phép của vật liệu chế tạo trục là: [σ] = 63 MPa.

Đường kính trục tại các mặt cắt được xác định theo công thức:

di = √
Mtđi
0,1.[σ]

3

Trong đó: [σ] là ứng suất cho phép của vật liệu chế tạo trục ([σ] = 63 MPa)

Mtd - Mô men tương đương trên các mặt cắt (Nmm)

Theo công thức 10.15[I] và 10.16[I] ta có:

Mi=√Myi
2 + Mxi

2

2

Mtd = √Mi
2 + 0,75. Ti

2

2

Trong đó: Myi; Mxi mô men uốn trong mặt phẳng yOz và xOz tại các tiết diện i .

Xét các mặt cắt tại trục I:

- Tại điểm (2): điểm lắp khớp nối
- Momen muốn Mx2= My2 = 0
- Momen xoắn Mz2 = T1 = 88965,9 (N.mm);
- Momen tương đương trên mặt cắt (2): Mtđ2 = √M2 + 0,75. Mz2
2 = √0,75. 88965,9
2 = 77046,73 (Nmm)

- Kích thước của trục tại mặt cắt (2): d2 =√
Mtđ2
0,1.[σ]

3

= √
77046,73
0,1.63

3
= 23.04(mm) ; Chọn d2 = 24 mm
- Tại điểm (0) - điểm có lắp ổ lăn:
- Momen uốn: Mx0 = 0(Nmm);
- Momen uốn: My0 = 69000 (Nmm);
- Momen xoắn: Mz0 = TI = 88965,9(N.mm);
- Momen tương đương trên mặt cắt (0):

M0 =√Mx0
2 + My0

2 = √0
2 + 69000 ²

2
= 69000 (Nmm)

Mtđ0=√M0
2 + 0,75. Mz0
2 | 2 = √69000 ² + 0,75. 88965,9
| 2
2 | = 103427,26 (Nmm)
- Kích thước của trục tại mặt cắt (0):
d0 = √
Mtđ0
0,1.[σ]

3

= √
103427,26
0,1.63

3
= 25,42 (mm) .Ta chọn d0= 30 mm
- Tại điểm (1) - điểm có ổ lăn :
- Momen uốn: Mx1 = 25068,49 (Nmm)
- Momen uốn: My1 = 93182 (Nmm)
- Mô men xoắn Mz1 =T1=88965,9(N.mm)
- Mô men tương đương trên mặt cắt (1):

M1=√Mx1
2 + My1

2

2
=√25068,49² + 93182²
2 | = 96495,15 (Nmm)

Mtđ1 = √M1
2 + 0,75. Mz1

2

| = √96495,15² + 0,75. 88965,9 2 =
123480,82 (Nmm)
- Kích thước của trục tại mặt cắt (1): d1 =√
Mtđ1
0,1.[σ]

3

=√
123480,82
0,1.63

3
= 26,96 (mm); Chọn d1 = 30 mm
- Tại vị trí (3) lắp bánh răng côn:

- Momen uốn Mx3 = 0 (Nmm)
- Momen uốn My3 =0 (Nmm)
- Momen xoắn Mz3 =T1= 88965,9 (Nmm)
- Momen tương đương trên mặt cắt (3):

M3=√Mx3
2 + My3

2

2
=√0
2 + 0

2

2
= 0 (Nmm)

Mtđ3 =√M3
2 + 0,75. Mz3

2

= √0
2 + 0,75. 88965,9

2 = 77046,73 (Nmm)

- Kích thước của trục tại mặt cắt (3): d3 =√
Mtđ3
0,1.[σ]

3

=√
77046,73
0,1.63

3
= 23,04 (mm); chọn d3 = 25 (mm).

c.Tính kiểm nghiệm trục về độ bền mỏi.

- Khi xác định đường kính trục theo công thức 10.17 [I], ta chưa xét tới các ảnh hưởng về độ bền mỏi của trục như đặc tính thay đổi của chu trình ứng suất, sự tập trung ứng suất, yếu tố kích thước, chất lượng bề mặt…. Vì vậy sau khi xác định được đường kính trục cần tiến hành kiểm nghiệm trục về độ bền mỏi có kể đến các yếu tố vừa nêu.
- Kết cấu của trục vừa thiết kế đảm bảo được độ bền mỏi nếu hệ số an toàn tại các tiết diện nguy hiểm thỏa mãn điều kiện sau đây theo công thức 10.19 [I]:

sj=

Sσj.Sτj

√Sσj
2 + Sτj

2

≥ [s]

Trong đó:

[s] - hệ số an toàn cho phép, s= (1,5….2,5); lấy [s]=2,5

sσj, sτj - hệ số an toàn chỉ xét riêng ứng suất pháp và hệ số an toàn chỉ xét riêng ứng suất tiếp tại mặt cắt j:

sσj =

(10.20)

σ | σ
σ | σ ψ

σ

K dj aj + mj

−

1

sτ j= | (10.21)

Với σ-1,τ -1 - giới hạn mỏi uốn và xoắn ứng với chu kỳ đối xứng, với thép 45 có

σb = 750 MPa.

Þ σ-1 = 0,436. σb = 0,436. 750 = 327 MPa

τ-1 = 0,58. σ-1 = 0,58. 327 = 189,66 MPa

ψσ ,ψτ - hệ số kể đến ảnh hưởng của trị số ứng suất trung bình tới độ bền

mỏi, theo bảng 10. 7 [I], với σb = 750 MPa, ta có:

ψσ = 0,1; ψτ = 0,05

- Đối với trục quay, ứng suất uốn thay đổi theo chu kỳ đối xứng theo CT 10.22 [I]:

σmj = 0; σaj = σmaxj =

- σaj, τaj, σmj, τmj là biên độ và trị số trung bình của ứng suất pháp và tiếp tại mặt cắt mà ta đang xét. Khi trục quay một chiều ứng suất xoắn thay đổi theo chu kỳ mạch động, theo CT 10.23 [I]:

τmj = τaj = =

Với Wj, Woj – momen cản uốn và momen cản xoắn tại mặt cắt đang xét.

Ta kiểm nghiệm cho mặt cắt tại điểm có lắp ổ lăn (0) và (1).

- Kiểm nghiệm cho mặt cắt (1):

Theo công thức 10.15[I], ta có:

M1=√Mx1
2 + My1

2

2
=√25068,49² + 93182²
2 | = 96495,15 (Nmm)
K dj aj | mj τ | ψ τ

τ
τ | | + τ −1

j

j
W

M

2

max j τ

oj

j
W

T
2.

Theo bảng 10.6[I] tính momen chống uốn và chống xoắn cho mặt cắt 3 của trục I:

W1 =

π.d1

3

32

−

b.t1.( d1−t1)

2

2d3

=

3,14.30³

32

−

8.5.( 30−5)

2

2.30

= 2232,71 (mm³
)

Trong đó:

b là chiều rộng rãnh then bằng: b=8 mm (tra bảng 9.1b[1])

t1 là chiều sâu của rãnh then:t1= 5 mm ( tra bảng 9.1b[1]))

Þ σm1= 0; σa1 =

M1
W1

=

96495,15
2232,71

=43,22 (N/mm²
)

Ứng suất xoắn :

T1 = TI = 88965,9 (Nmm) ;

W01 =

π.d1

3

16

−

b.t1.( d1−t1)

2

2d1

=

3,14.30³

16

−

8.5.( 30−5)

2

2.30

= 4882,08(mm³
)

Þ τa1 = τm1 =

T1
2.W01

=

88965,9
2.4882,08

= 9,11(N/mm²
)

Hệ số Kσdj và Kτdj được xác định theo các CT10.25[I]; CT10.26[I]:

Kσdj =

Kτdj =

Trong đó:

Kx - hệ số tập trung ứng suất do trạng thái bề mặt phụ thuộc vào phương pháp gia công và độ nhẵn bóng bề mặt. Theo bảng 10.8 [I] ta có:

Kx = 1,1 với σb = 750 MPa, tiện đạt Ra 2,5…0,63;

y

x

K

K

K
+ −1

σ

σε

y

x

K

K

K
+ −1

τ

τε

Ky - hệ số tăng bền bề mặt trục nhẵn, tra bảng 10. 9 [1], ta dùng phương pháp gia công thấm cacbon tăng bền bề mặt, ta có: Ky = [1,4…1,5]. Chọn Ky=1,5.

εσ , ετ - hệ số kể đến ảnh hưởng kích thước mặt cắt trục, đối với trục làm bằng vật liệu thép Cacbon có đường kính d1 = 30 (mm),

theo bảng 10. 10 [I], ta có: εσ = 0,88; ετ = 0,81

Kσ , Kτ - trị số của hệ số tập trung ứng suất thực tế trên bề mặt trục, đối với trục có rãnh then và gia công bằng dao phay ngón.

Theo bảng 10.12[I], ta có với σb= 750 MPa => Kσ = 2,01; Kτ = 1,88

Thay các giá trị trên vào công thức ta được:

Kσd1 = | =

2,01
0,88

+1,1−1

1,5

= 1,59

Kτd1 = | =

1,88
0,81

+1,1 −1

1,5

= 1,61

Thay các kết quả trên vào CT 10.20[I]; CT10.21[I], ta tính được:

sσ1 =

σ−1

Kσd3.σạ1+ψσ

.σm1

=

327
| 1,59.43,22 +0,1.0

= 4,76

sτ1=

τ−1

Kτd1.τa1+ψτ

.τm1

=

189,66
| 1,61.9,11+0,05.9,11

= 12,54

Theo CT 10,19[I], ta tính được:

s1 =

sσ1.sτ1

√sσ1
2 +sτ1

2

=

4.76.12,54 √ 4,76²+12,54² | = 4,45 > [s] = 2,5=> mặt cắt (1) đủ bền

độ bền mỏi

Xét các mặt cắt tương tự cho mặt cắt (0), ta được:

s0 = 2,78 ≥ 2,5(đủ độ bền mỏi)

y

x

K

K

K
+ −1

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
+ −1

τ

τ
ε

d. Kiểm nghiệm độ bền tĩnh của trục

Tại mặt cắt (1) là mặt cắt nguy hiểm, kiểm nghiệm độ bền tĩnh của trục tại mặt (1)

σtd1 = √σ1
2 + 3τ1

2 ≤ [σ] (10.16-[1])

σ1 =

Mmax
0,1.d1

3

τ1 =

Tmax
0,1.d1

3

(10.17-[1])

Lại có:

M1max = M1 = √Mx1
2 + My1

2 = √25068,49² + 93182²
2 | = 96495,15 (Nmm)

T1 = T1max = 88965,9 (Nmm)

Thế vào công thức trên ta được:

σ1 =

M1max
0,1. d1

3 =

96495,15
| 0,1. 30³ = 35,74 (MPa)

τ1 =

Tmax
0,1. d1

3 =

88965,9
0,1. 30³ = 32,95 (MPa)
- σtd1 = √σ1
2 + 3τ1

2 = √35,74² + 3. 32,95² = 67,34 (MPa) ≤ [σ] = 0,8.σcℎ = 0,8.450 = 360 (MPa) (thỏa mãn điều kiện bền)

### 5. Tính toán thiết kế trục II

a. Sơ đồ đặt lực trên trục II

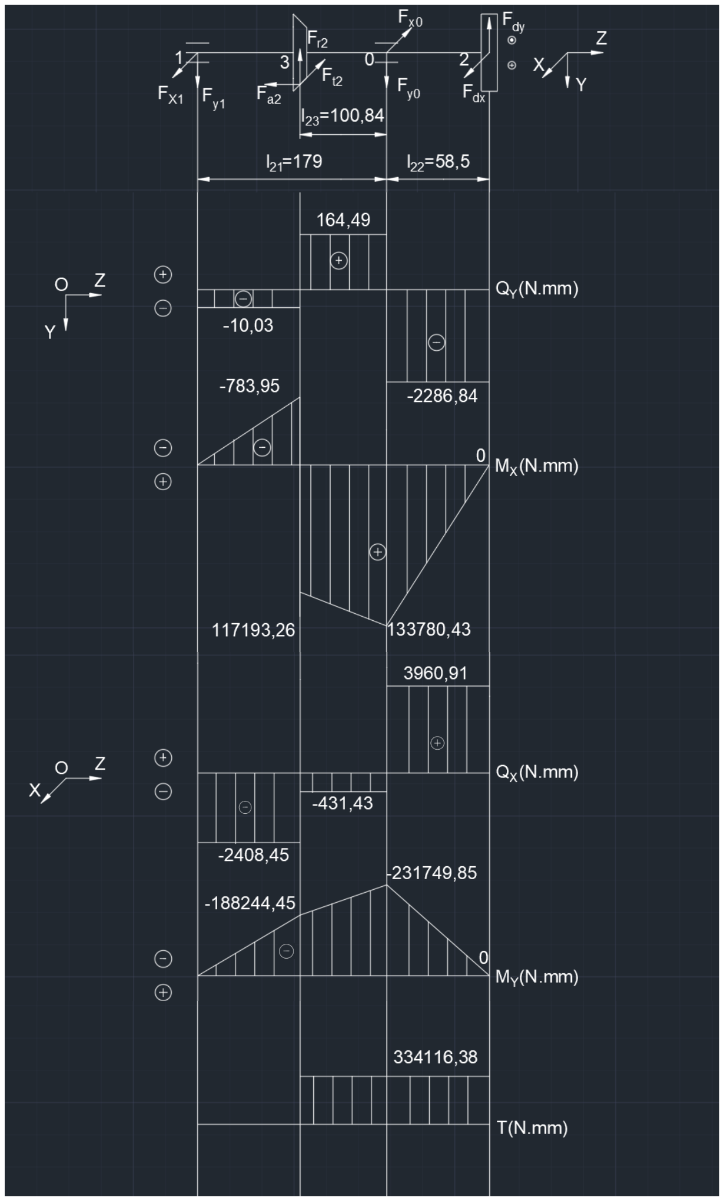
[picture p5: figure]

b. Xác định các lực tác dụng lên trục II:

+ Lực vòng: Ft2 = Ft1 = 1977,02(N)

+Lực hướng trục: Fa2 = Fr1 = 698,09 (N)

+ Lực hướng kính: Fr2 = Fa1 = 174,52(N)

- Lực của đĩa xích tác dụng lên trục:

Vì đường nối tâm của bộ truyền đai làm với phương ngang 1 góc α = 30o do đó lực Fr từ đĩa xích tác dụng lên trục được phân tích thành hai lực: Fr = 4573.67 (N)

Fdx = Frcos(α) = 4573.67. cos(30) = 3960,91(N)

Fdy = Frsin(α) = 4573.67. sin(30) = 2286,84(N)

c. Tính toán phản lực tại các gối đỡ (0) và (1)
- Giả sử chiều của các phản lực tại các gối đỡ (0) và (1) theo hai phương x và y như hình vẽ. Ta tính toán được các thông số như sau:

+ Xét moment trên mặt phẳng (yOz):

∑MX(0) = −Fr2l23 + Fy1l21 + Fdyl22 − Fa2

dm2
2

= 0

=> Fy1 =

Fr2l23 + Fa2

dm2
2

− Fdyl22
l21

=

174,52.100,84 + 698,09.

338
2

− 2286,84.58,5
179 | = 10.03(N)

+ Xét các lực theo phương y:

∑Fy = Fy0 − Fr2 + Fy1 − Fdy = 0

=> Fy0 = Fr2 − Fy1 + Fdy = 174,52 − 10,03 + 2286,84 = 2451,33 (N)

+ Xét moment trên mặt phẳng (xOz):

∑My(0) = −Ft2l23 + Fx1 l21 − Fdxl22 = 0

Fx1 =

Ft2l23 + Fdxl22
l21

=

1977,02.100,84 + 3960,91.58,5
179 | = 2408,45(N)

+ Xét các lực theo phương x:

∑Fx = −Fx0 − Ft2 + Fx1 + Fdx = 0

Fx0 = Fdx + Fx1 − Ft2 = 3960,91 + 2408,45 − 1977,02 = 4392,34 (N)

+ Mô men gây ra trên bánh răng hai:

Ma2 = Fa2.

dm2
2

= 698,09.

338
2

= 117977,21 (Nmm)

T2 = Ft2.

dm2
2

= 1977,02.

338
2

= 334116,38 (Nmm)

Xét các mặt cắt tại trục II:

- Tại điểm (2): điểm lắp đĩa xích bị động
- Momen muốn Mx2= My2 = 0
- Momen xoắn Mz2 = T2 = 334116,38 (N.mm);
- Momen tương đương trên mặt cắt (2):
Mtđ2 = √M2 + 0,75. Mz2
2 = √0,75. 334116,38 ² = 289353,27(Nmm)
- Kích thước của trục tại mặt cắt (2): d2 =√
Mtđ2
0,1.[σ]

3

= √
289353,27
0,1.63

3
= 35,8(mm) ; Chọn d2 = 36 mm
- Tại điểm (1) - điểm có lắp ổ lăn:
- Momen uốn: Mx1 = 0 (Nmm);
- Momen uốn: My1 = 0 (Nmm);

- Momen xoắn: Mz1 = 0 (N.mm);
- Momen tương đương trên mặt cắt (0): Mtđ1=√M1
2 + 0,75. Mz1
2 | 2 = 0 (Nmm)

Chọn d1 = 40 mm

- Tại điểm (0) - điểm có ổ lăn :
- Momen uốn: Mx0 = 133780,43 (Nmm)
- Momen uốn: My0 = 231749,85 (Nmm)
- Mô men xoắn Mz0 =T1=334116,38 (N.mm)
- Mô men tương đương trên mặt cắt (1):

M0=√Mx0
2 + My0

2

2
=√133780,43² + 231749,85²
2 | = 267591,47 (Nmm)

Mtđ0 = √M0
2 + 0,75. Mz0

2

| = √267591,47² + 0,75. 334116,38² =
394119,92 (Nmm)
- Kích thước của trục tại mặt cắt (0): d0 =√
Mtđ0
0,1.[σ]

3

=√
394119,92
0,1.63

3
= 39,7 (mm); Chọn d0 = 40 mm
- Tại vị trí (3) lắp bánh răng côn:
- Momen uốn Mx3 = 117193,26 (Nmm)
- Momen uốn My3 = 188244,45(Nmm)
- Momen xoắn Mz3 =T1= 334116,38 (Nmm)
- Momen tương đương trên mặt cắt (3):

M3=√Mx3
2 + My3

2

2
=√117193,26² + 188244,45²
2 | = 221743,62 (Nmm)

Mtđ3 =√M3
2 + 0,75. Mz3

2

| = √221743,62² + 0,75. 334116,38 ² =
364548,42 (Nmm)
- Kích thước của trục tại mặt cắt (3): d3 =√
Mtđ3
0,1.[σ]

3

=√
364548,42
0,1.63

3
= 38,68 (mm); chọn d3 = 45 (mm).

d. Tính kiểm nghiệm trục về độ bền mỏi.
- Khi xác định đường kính trục theo công thức 10.17 [I], ta chưa xét tới các ảnh hưởng về độ bền mỏi của trục như đặc tính thay đổi của chu trình ứng suất, sự tập trung ứng suất, yếu tố kích thước, chất lượng bề mặt…. Vì vậy sau khi xác định được đường kính trục cần tiến hành kiểm nghiệm trục về độ bền mỏi có kể đến các yếu tố vừa nêu.
- Kết cấu của trục vừa thiết kế đảm bảo được độ bền mỏi nếu hệ số an toàn tại các tiết diện nguy hiểm thỏa mãn điều kiện sau đây theo công thức 10.19 [I]:

sj=

Sσj.Sτj

√Sσj
2 + Sτj

2

≥ [s]

Trong đó:

[s] - hệ số an toàn cho phép, s= (1,5….2,5); lấy [s]=2,5

sσj, sτj - hệ số an toàn chỉ xét riêng ứng suất pháp và hệ số an toàn chỉ xét riêng ứng suất tiếp tại mặt cắt j:

sσj =

(10.20)

sτ j= | (10.21)

Với σ-1,τ -1 - giới hạn mỏi uốn và xoắn ứng với chu kỳ đối xứng, với thép 45 có

σb = 750 MPa.

Þ σ-1 = 0,436. σb = 0,436. 750 = 327 MPa

τ-1 = 0,58. σ-1 = 0,58. 327 = 189,66 MPa

ψσ ,ψτ - hệ số kể đến ảnh hưởng của trị số ứng suất trung bình tới độ bền

mỏi, theo bảng 10. 7 [I], với σb = 750 MPa, ta có:

| ψσ = 0,1; ψτ = 0,05
- Đối với trục quay, ứng suất uốn thay đổi theo chu kỳ đối xứng theo CT 10.22 [I]:
σ | σ
σ | σ ψ

σ

K dj aj + mj

−

1

K dj aj | mj τ | ψ τ

τ
τ | | + τ −1

σmj = 0; σaj = σmaxj =

- σaj, τaj, σmj, τmj là biên độ và trị số trung bình của ứng suất pháp và tiếp tại mặt cắt mà ta đang xét. Khi trục quay một chiều ứng suất xoắn thay đổi theo chu kỳ mạch động, theo CT 10.23 [I]:

τmj = τaj = =

Với Wj, Woj – momen cản uốn và momen cản xoắn tại mặt cắt đang xét.

Ta kiểm nghiệm cho mặt cắt tại điểm có lắp ổ lăn (0) và (1).

- Kiểm nghiệm cho mặt cắt (3):

Theo công thức 10.15[I], ta có:

M3=√Mx3
2 + My3

2

2
=√117193,26² + 188244,45²
2 | = 221743,62 (Nmm)

Theo bảng 10.6[I] tính momen chống uốn và chống xoắn cho mặt cắt 3 của trục I:

W3 =

π.d3

3

32

−

b.t1.( d3−t1)

2

2d3

=

3,14.45³

32

−

14.5,5.( 45−5,5)

2

2.45

| = 7606,76 (mm³ )

Trong đó:

b là chiều rộng rãnh then bằng: b=14 mm (tra bảng 9.1b[1])

t1 là chiều sâu của rãnh then:t1= 5.5 mm ( tra bảng 9.1b[1]))

Þ σm3= 0; σa3 =

M3
W3

=

221743,62
7606,76
| = 29,15 (N/mm² )

Ứng suất xoắn :

T3 = T2 = 334116,38 (Nmm);

W03 =

π.d3

3

16

−

b.t1.( d3−t1)

2

2d3

=

3,14.45³

16

−

14.5,5.( 45−5,5)

2

2.45

| = 16548,4(mm³ )

j

j
W

M

2

max j τ

oj

j
W

T
2.

Þ τa3 = τm3 =

T3
2.W03

=

334116,38
2.16548,4

= 10,1(N/mm²
)

Hệ số Kσdj và Kτdj được xác định theo các CT10.25[I]; CT10.26[I]:

Kσdj =

Kτdj =

Trong đó:

Kx - hệ số tập trung ứng suất do trạng thái bề mặt phụ thuộc vào phương pháp gia công và độ nhẵn bóng bề mặt. Theo bảng 10.8 [I] ta có :

Kx = 1,1 với σb = 750 MPa, tiện đạt Ra 2,5…0,63;

Ky - hệ số tăng bền bề mặt trục nhẵn, tra bảng 10. 9 [1], ta dùng phương pháp gia công thấm cacbon tăng bền bề mặt, ta có: Ky = [1,4…1,5]. Chọn Ky=1,5.

εσ , ετ - hệ số kể đến ảnh hưởng kích thước mặt cắt trục, đối với trục làm bằng vật liệu thép Cacbon có đường kính d3 = 40 (mm),

theo bảng 10. 10 [I], ta có: εσ = 0,85; ετ = 0,78

Kσ , Kτ - trị số của hệ số tập trung ứng suất thực tế trên bề mặt trục, đối với trục có rãnh then và gia công bằng dao phay ngón.

Theo bảng 10.12[I], ta có với σb= 750 MPa => Kσ = 2,01; Kτ = 1,88

Thay các giá trị trên vào công thức ta được:

Kσd3 = | =

2,01
0,85 +1,1−1

1,5

= 1,64

Kτd3 = | =

1,88
0,78

+1,1 −1

1,5

= 1,67

y

x

K

K

K
+ −1

σ

σε

y

x

K

K

K
+ −1

τ

τε

y

x

K

K

K
+ −1

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
+ −1

τ

τ
ε

Thay các kết quả trên vào CT 10.20[I]; CT10.21[I], ta tính được:

sσ3 =

σ−1

Kσd3.σạ3+ψσ

.σm3

=

327
1,64.29,15 +0,1.0

= 6,84

sτ3=

τ−1

Kτd3.τa3+ψτ

.τm3

=

189,66
1,78.10,1+0,05.10,1

= 10,26

Theo CT 10,19[I], ta tính được:

s3 =

sσ3.sτ3

√sσ3
2 +sτ3

2

=

6,84.10,26
√ 6,84²+10,26²

= 5,69 > [s] = 2,5=> mặt cắt (3) đủ bền

độ bền mỏi

Xét các mặt cắt tương tự cho mặt cắt (0) ta được:

{s0 = 5,17 ≥ 2,5(đủ độ bền mỏi)

e. Kiểm nghiệm độ bền tĩnh của trục

Tại mặt cắt (0) là mặt cắt nguy hiểm, kiểm nghiệm độ bền tĩnh của trục tại mặt (0)

σtd0 = √σ0
2 + 3τ0

2 ≤ [σ] (10.16-[1])

σ0 =

Mmax
0,1.d0

3

τ0 =

Tmax
0,1.d0

3

(10.17-[1])

Lại có:

M2max = M0 = √Mx0
2 + My0

2 = √267591,47² + 334116,38²

= 428064,19(Nmm)

T0 = T2max = 334116,38 (Nmm)

Thế vào công thức trên ta được:

σ1 =

Mmax
0,1. d0

3 =

428064,19
0,1. 40³ = 66,89

τ0 =

Tmax
0,1. d0

3 =

334116,38
0,1. 40³ = 52,21 (MPa)
- σtd1 = √σ1
2 + 3τ1

2 = √66,89² + 3. 52,21² = 112,48 (MPa) ≤ [σ] = 360 (MPa) (thỏa mãn điều kiện bền)

PHẦN THEN, Ổ LĂN, KHỚP NỐI

A. THEN

### 1. Chọn then

Đường kính trục d | Kích thước tiết diện then | Chiều sau rãnh then | Bán kính góc lượn rãnh then r
b | h | Trên trục t1 | Trên Mayơ t2 | Nhỏ nhất | Lớn nhất
d12 = 24 mm | 8 | 7 | 4 | 2,8 | 0,16 | 0,25
d13 = 25 mm | 8 | 7 | 4 | 2,8 | 0,16 | 0,25
d22 = 36 mm | 10 | 8 | 5 | 3,3 | 0,25 | 0,4
d23 = 45 mm | 14 | 9 | 5,5 | 3,8 | 0,25 | 0,4

Chiều dài then được tính theo công thức: lt = (0,8 ÷ 0,9)lm
lt12 = (0,8 ÷ 0,9) ∗ 59 = 48mm
lt13 = (0,8 ÷ 0,9) ∗ 39 = 32mm
lt22 = (0,8 ÷ 0,9) ∗ 54 = 45mm
lt23 = (0,8 ÷ 0,9) ∗ 52 = 40mm

### 2. Kiểm nghiệm độ bền dập và độ bền cắt

- Điều kiện bền dập của then:
Với vật liệu thép C45, lắp cố định, tải trọng tỉnh [σd ] = 150 MPa

σdj =

2Tj
(ℎ − t1)dj

ltj

≤ [σd

]

- Điều kiện bền cắt của then:
Với vật liệu thép C45, tải trọng tỉnh [τc

] = 60 ÷ 90 MPa

σcj =

2Tj
dj

ltjb

≤ [τc

]

Kết quả tính kiểm nghiệm then đối với các chi tiết gắn then
d(mm) | lt | bxℎ | t1 | T(Nmm) | σd(MPa) | τc(MPa)
24 | 48 | 8x7 | 4 | 72794 | 42,13 | 15,8
25 | 32 | 8x7 | 4 | 72794 | 63,19 | 23,7
36 | 45 | 10x8 | 5 | 278352 | 114,55 | 34,36
45 | 44 | 14x9 | 5,5 | 278352 | 80,33 | 20,08

B. Ổ LĂN

### 1. TRỤC 1

a) Thông số đầu vào:
- Phản lực tại 0: Fx0 = 2954,65N, Fy0 = 302,03N => Fr0 = √Fx0
2 + Fy0

2 = √2954,65² + 302,03² = 2970,04N

- Phản lực tại 1: Fx1 = 3931,67N, Fy1 = 1000,12N => Fr1 = √Fx1
2 + Fy1

2 = √3931,67² + 1000,12² = 4056,88N

- Lực dọc trục Fa = 174,52N
- Số vòng quay của trục 1: n = 715 vg/pℎ
- Thời gian làm việc của ổ: Lℎ = 18000 giờ
b) Chọn loại ổ lăn:
Do Fa

Fr0

= 0,06 < 0,3 và đường kính lắp ổ d = 30mm nên chọn ổ đũa

côn cỡ trung có các thông số sau:

c) Tính kiểm nghiệm khả năng tải của ổ.
Ta tiến hành kiểm nghiệm cho tải chịu tải trọng lớn hơn
- Tải trọng động quy ước Q đối với ổ đũa côn một dãy: Q = (XVFr + YFa)ktkđ

Trong đó:

Fr = 698.09N, Fa = 174,52N: lần lượt là tải trọng hướng tâm và tải trọng dọc trục.
V: hệ số kể đến vòng nào quay, với vòng trong quay V = 1

kt

: hệ số kể đến ảnh hưởng của nhiệt độ, với nhiệt độ làm việc dưới 100oC kt = 1.

kđ

: hệ số kể đến đặc tính tải trọng, với tải trong không đổi kđ = 1

X: hệ số tải trọng hướng tâm.

Y: hệ số tải trọng dọc trục.

Kí hiệu | d(mm) | D(mm) | α(o ) | C(kN) | C0(kN)
7306 | 30 | 72 | 13,5 | 40 | 29,9

Ta có:
e = 1,5tgα = 1,5 ∗ tg(13,5) = 0,36

Đồng thời:

Fa
VFr

=

174,52
698,09 = 0,25 < e => X = 1, Y = 0

=> Q = (XVFr + YFa

)ktkđ

= (1 ∗ 1 ∗ 698,09 + 0 ∗ 174,52) ∗ 1 ∗ 1 = 0,698 kN

Tuổi thọ thời gian làm việc:

L =

60 ∗ n ∗ Lℎ
10⁶ =

60 ∗ 715 ∗ 18000
10⁶ | = 772,2 triệu vòng quay

Khả năng tải động:

Do sử dụng ổ đũa nên m = 10/3

Cd = Q. √L

m
= 0,698. √772,2
3 | = 6,41kN < C = 40kN

=> Đảm bảo khả năng tải động

- Khả năng tải tỉnh:
Qt = XoFr + YoFa
Trong đó
Fr = 698,09N, Fa = 174,52N: lần lượt là tải trọng hướng tâm và tải trọng dọc trục.
Xo = 0.5: hệ số tải trọng hướng tâm.

Yo = 0,22cotg(13,5) = 0,92: hệ số tải trọng dọc trục.

=> Qt = XoFr + YoFa
= 0.5 ∗ 698,09 + 0,92 ∗ 174,52 = 0,51kN < C0 = 29,9kN

=> Đảm bảo khả năng tải động

### 2. TRỤC 2

a) Thông số đầu vào:
- Phản lực tại (0): Fx0 = 4392,34N, Fy0 = 2451,33N

=> Fr0 = √Fx0
2 + Fy0

2 = √4392,34² + 2451,33² = 5030,08N

- Phản lực tại (1): Fx1 = 2408,45N, Fy1 = 10,03N

=> Fr1 = √Fx1
2 + Fy1

2 = √2408,45² + 10,03² = 2408,47N

- Lực dọc trục Fa = 698,09N
- Số vòng quay của trục 2: n = 178,75 vg/pℎ
- Thời gian làm việc của ổ: Lℎ = 18000 giờ
b) Chọn loại ổ lăn:
Do Fa

Fr0

= 0.14 < 0.3 và đường kính lắp ổ d = 40mm nên chọn ổ đũa

côn cỡ trung có các thông số sau:

c) Tính kiểm nghiệm khả năng tải của ổ.
Ta tiến hành kiểm nghiệm cho tải chịu tải trọng lớn hơn
- Tải trọng động quy ước Q đối với ổ bi đỡ chặn: Q = (XVFr + YFa)ktkđ

Trong đó:

Fr = 174,52N, Fa = 698,09N: lần lượt là tải trọng hướng tâm và tải trọng dọc trục.
V: hệ số kể đến vòng nào quay, với vòng trong quay V = 1

kt

: hệ số kể đến ảnh hưởng của nhiệt độ, với nhiệt độ làm việc dưới 100oC kt = 1.

kđ

: hệ số kể đến đặc tính tải trọng, với tải trong không đổi kđ = 1

X: hệ số tải trọng hướng tâm.

Y: hệ số tải trọng dọc trục.

Ta có:
e = 1,5tgα = 1,5 ∗ tg(10,5) = 0,27
Kí hiệu | d(mm) | D(mm) | α(o ) | C(kN) | C0(kN)
7308 | 40 | 90 | 10,5 | 61 | 46

Đồng thời:

Fa
VFr

=

698,09
174,52 = 4 > e => X = 0,4, Y = 0,4cotg(10,5) = 2,16

=> Q = (XVFr + YFa

)ktkđ

= (0,4 ∗ 1 ∗ 174,52 + 2,16 ∗ 698,09) ∗ 1 ∗ 1 = 1.57kN

Tuổi thọ thời gian làm việc:

L =

60 ∗ n ∗ Lℎ
10⁶ =

60 ∗ 178.75 ∗ 18000
10⁶ | = 193,05 triệu vòng quay

Khả năng tải tỉnh:
Do sử dụng ổ đũa nên m = 10/3

Cd = Q. √L

m
= 1,57√193,05 ³ | = 9,07kN < C = 61kN

=> Đảm bảo khả năng tải động

- Khả năng tải tỉnh:
Qt = XoFr + YoFa
Trong đó
Fr = 174,52N, Fa = 698,09N: lần lượt là tải trọng hướng tâm và tải trọng dọc trục.
Xo = 0,5: hệ số tải trọng hướng tâm.

Yo = 0,22cotg(10,5) = 1,19: hệ số tải trọng dọc trục.

=> Qt = XoFr + YoFa
= 0.5 ∗ 174,52 + 1,19 ∗ 698,09 = 0,92kN < C0 = 46kN

=> Đảm bảo khả năng tải tỉnh

C. KHỚP NỐI

### 1. Thông số đầu vào

- Mômen trên trục 1: T = 72794Nmm
- Số vòng quay: n = 715 vg/pℎ

### 2. Chọn nối trục

- Chọn khớp nối vòng đàn hồi.

### 3. Tính kiểm nghiệm bền

- Mômen xoắn tính toán:

Tt = k ∗ T = 1.8 ∗ 72794 = 131029,2 Nmm Trong đó:
T: là mômen danh nghĩa truyền qua khớp nối.
k = 1,8: hệ số chế độ làm việc (xích tải).
- Với Tt đã tính tra bảng được: Z = 6; D0 = 105mm; dc = 14mm; l3 = 28mm;

l0 = l1 +

l2
2

= 30 +

32
2

= 46mm
+ Điều kiện sức bền dập của vòng đàn hồi:

σd =

2kT
ZD0dc

l3

=

2 ∗ 1,8 ∗ 72794
6 ∗ 105 ∗ 14 ∗ 28 = 1,06 MPa ≤ [σ]d = 3 MPa

=> thõa mản điều kiện về sức bền dập của vòng đàn hồi.

+ Điều kiện sức bền dập của chốt:

σu =

kTl0
0.1dc

3D0Z

=

1,8 ∗ 72794 ∗ 46
0,1 ∗ 14³ ∗ 105 ∗ 6

= 34,87 MPa ≤ [σ]u

= 70 MPa
=> thõa mản điều kiện về sức bền dập của chốt.

### 4. Tính lực tác dụng lên trục

Frkn = (0,2 ÷ 0,3)Ftkn = 0,25 ∗

2T1
Dt

= 0.25 ∗

2 ∗ 72794
71 = 512,63 N

Do: Tt khoảng 73 Nm nên ta chọn Dt = 71.

PHẦN TÍNH TOÁN VỎ HỘP, CÁC CHI TIẾT PHỤ

A. THÂN VỎ HỘP
Ta chọn vỏ hộp đúc, vật liệu gang xám GX 15-32
Chọn bề mặt lắp ghép giữa nắp hộp và thân hộp đi qua đường tâm các trục để việc tháo lắp các chi tiết được thuận lợi dễ dàng.
Tên gọi | Biểu thức tinh toán
Chiều dày: Thân hộp δ Nắp hộp δ1 | δ = 0.03a + 3 = 0.03 ∗ 173,17 + 3 = 8,2 → δ = 9mm δ1 = 0.9 ∗ 9 = 8.1 → δ1 = 9mm
Gân tăng cứng: Chiều dày e Chiều cao ℎ Độ dốc | e = (0.8 ÷ 1) δ = 7.2 ÷ 9 → e = 8mm ℎ < 58 → ℎ = 45mm kℎoảng 2°
Đường kính: -Bulong nền d1 -Bulong cạnh ổ d2 -Bulong ghép bích nắp và thân d3 -Vít ghép nắp d4 | d1 > 0.04a + 10 = 16,93 Cℎọn d1 = 17 mm d2 = (0.7 ÷ 0.8)d1 = 11.9 ÷ 13.6 → Cℎọn d2 = 12 mm d3 = (0.8 ÷ 0.9)d2 = 9.6 ÷ 10.8 → Cℎọn d3 = 10 mm d4 = (0.6 ÷ 0.7)d2 = 7.2 ÷ 8.4 → Cℎọn d4 = 8 mm
Vít ghép nắp cửa thăm d5 | d5 = (0.5 ÷ 0.6)d2 = 6 ÷ 7.2 → Cℎọn d5 = 7 mm
Mặt bích ghép nắp và thân: -Chiều dày bích thân hộp S3 -Chiều dày bích nắp hộp S4 -Bề rộng bích nắp và thân K3 | S3 = (1.4 ÷ 1.8)d3 = 14 ÷ 18 → Cℎọn S3 = 16 mm S4 = (0.9 ÷ 1)S3 = 14.4 ÷ 16 → Cℎọn S4 = 15 mm K3 = K2 - (3 ÷ 5) = 35 ÷ 33 → Cℎọn K3 = 40 mm
Kích thước gối trục: -Đường kinh ngoài và tâm lỗ vít D3 D2 -Bề rộng mặt ghép bulong cạnh ổ K2 -Tâm lổ bulong cạnh ổ: E2 và C | Trục 1 D3 = 115 mm D2 = 90 mm Trục 2 D3 = 115 mm D2 = 90 mm K2 = E2 + R2 + (3 ÷ 5) = 45 mm E2 = 1.6d2 = 19.2 mm R2 = 1.3d2 = 15.6 mm C = D3/2 = 115/2 = 58

Mặt đế hộp: Chiều dày: khi không có phần lồi S1 Khi có phần lồi: Dd S1 và S2 Bề rộng mặt đế hộp K1 và q | S1 = (1,3÷1,5) d1 = 23mm Dd xác định theo đường kính dao khoét S1 = (1,4÷1,7) d1 = 25mm S2 = (1÷1,1)d1 = 18mm K1 = 3d1 = 51 mm q ≥ K1 + 2δ = 70 mm
Khe hở giữa các chi tiết: Giữa bánh răng với thành trong hộp (∆) Giữa đỉnh bánh răng lớn với đáy hộp (∆1) Giữa mặt bên các bánh rang với nhau | ∆≥ (1 ÷ 1,2)δ = 10 ∆1≥ (3 ÷ 5)δ = 40 ∆≥ δ → ∆= 10
Số lượng bulong nền Z | Z = (L+B)/(200÷ 300) L và B là chiều dài và rộng của hộp

Gối trục 1:
Chọn chiều dày cóc lót là 8mm → kích thước trong của cóc lót là: 72+2*8=88mm Tra bảng ra được đường kính ngoài của gối trục D3 là 135mm

Gối trục 2:
Kích thước lắp ổ lăn là 90mm → Tra bảng ra được đường kính ngoài của gối trục D3 là 135mm

CÁC CHIT TIẾT PHỤ

1. Nút tháo dầu

Dùng để tháo dầu cũ ra sau một thời gian dài làm việc, dầu bôi trơn chứ trong hộp bị bẩn do bụi hoặc do hạt mài hoặc bị biến chất

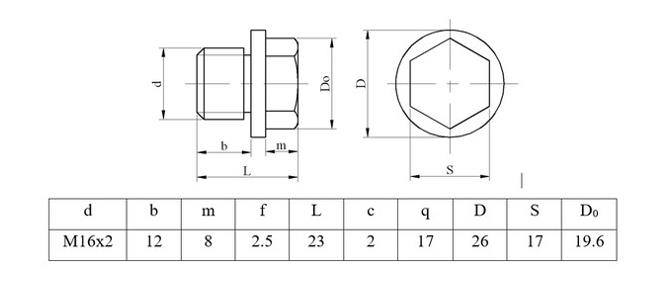
[picture p6: figure]
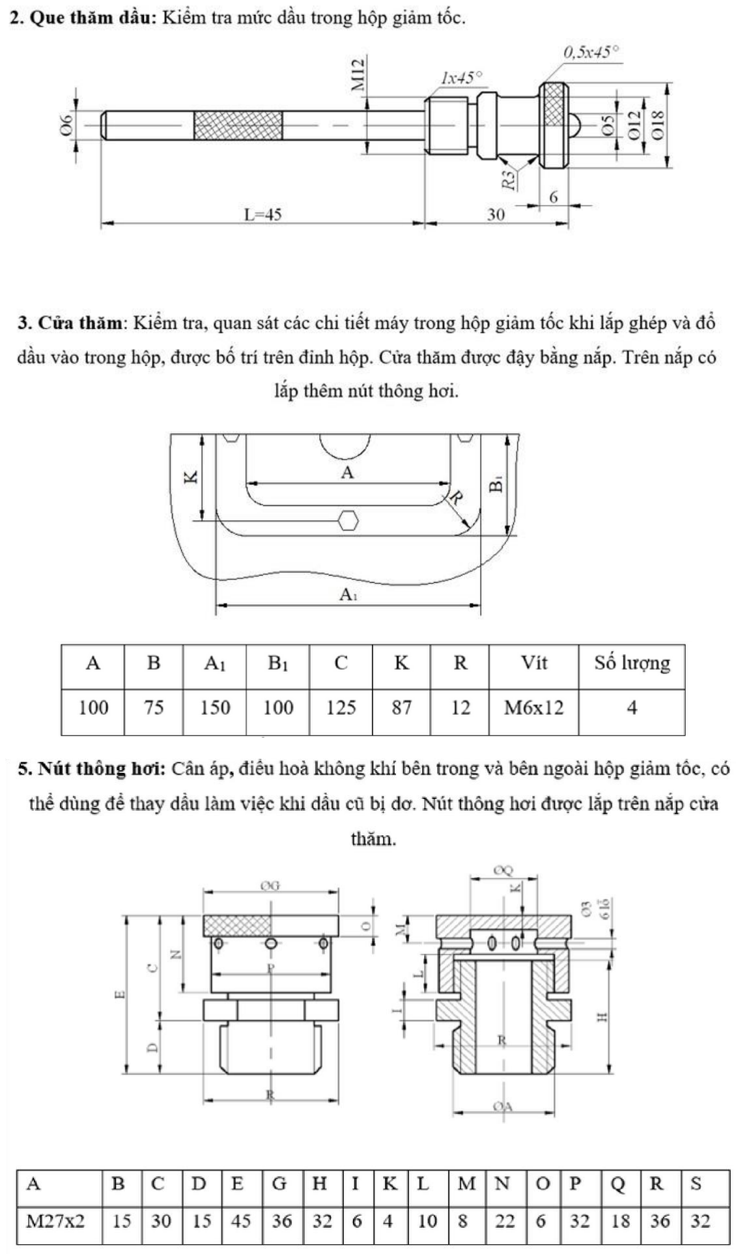
[picture p7: page 50]
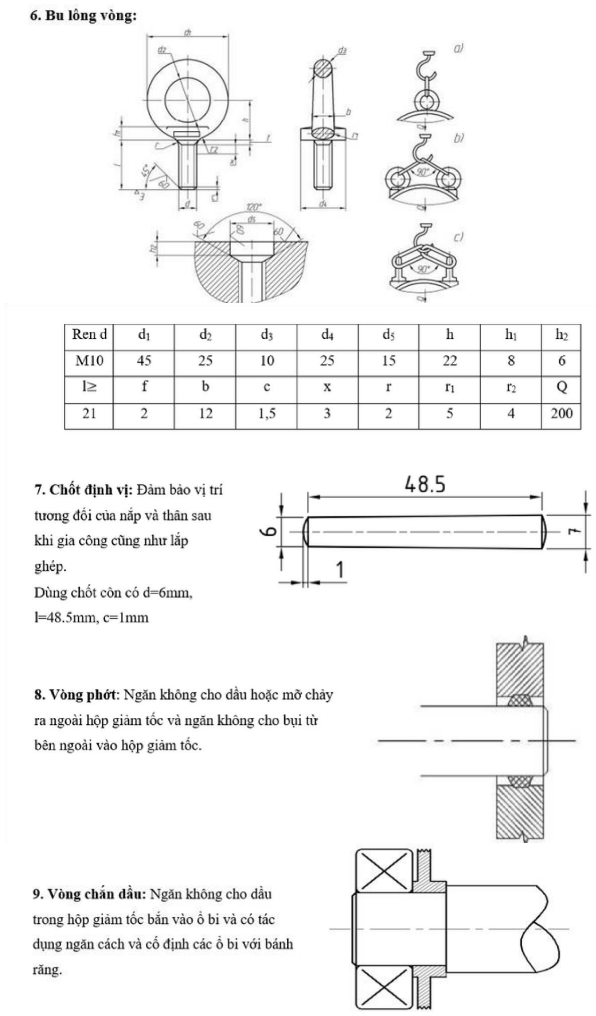
[picture p8: page 51]
