doanthanhnam1/Gear-reduce/(list of files, cad)

Other CAD files:
drawing_gear_reduce.dwg
